DavidMFlynn/MapperRover/TrackUnit/PrintedParts/STL Files/SidePlateOutside.dxf

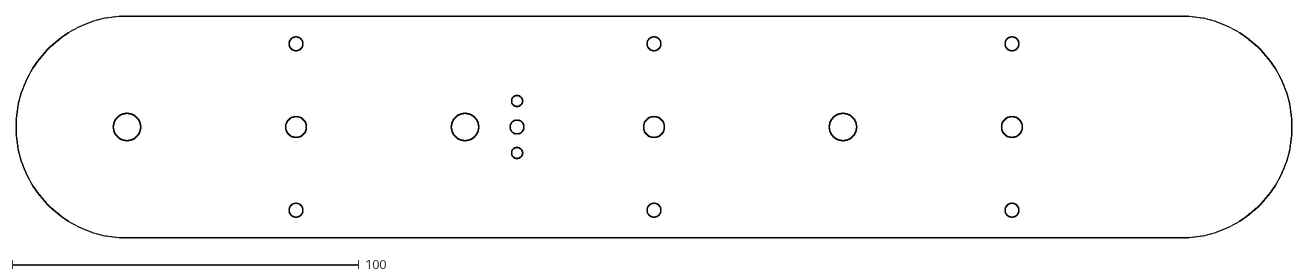
[picture p1: CAD file, 2017-04-08]
TrackUnit/PrintedParts/STL Files/SidePlateOutside.dxf
368.0 x 64.0
