DavidMFlynn/MapperRover/TrackUnit/PrintedParts/STL Files/RollPlate.stl

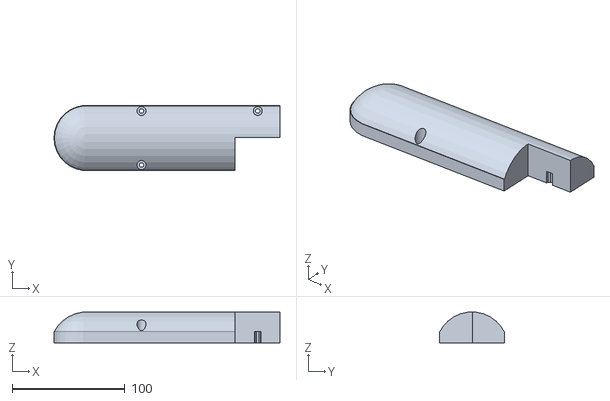
[picture p2: CAD file, 2017-04-08]
TrackUnit/PrintedParts/STL Files/RollPlate.stl
200.8 x 57.7 x 27.3
