DavidMFlynn/MapperRover/TrackUnit/PrintedParts/STL Files/IdleWheel.stl

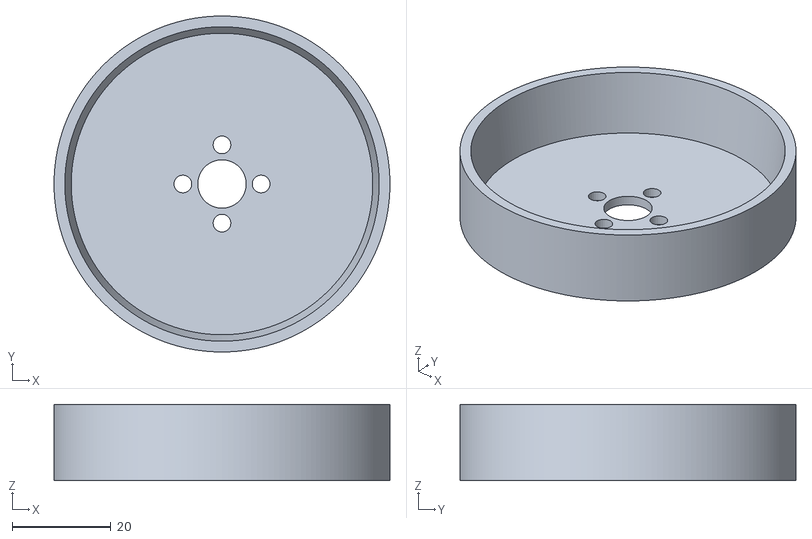
[picture p3: CAD file, 2017-04-08]
TrackUnit/PrintedParts/STL Files/IdleWheel.stl
68.0 x 68.0 x 15.4
