DavidMFlynn/MapperRover/TrackUnit/PrintedParts/STL Files/SidePlateInside.dxf

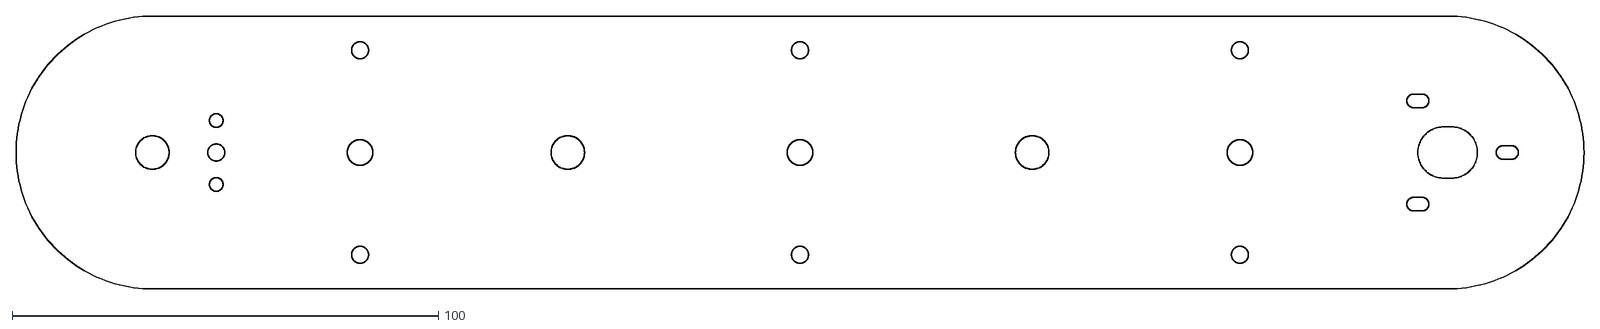
[picture p4: CAD file, 2017-04-08]
TrackUnit/PrintedParts/STL Files/SidePlateInside.dxf
368.0 x 64.0
