DavidMFlynn/MapperRover/TrackUnit/PrintedParts/STL Files/SidePlate.stl

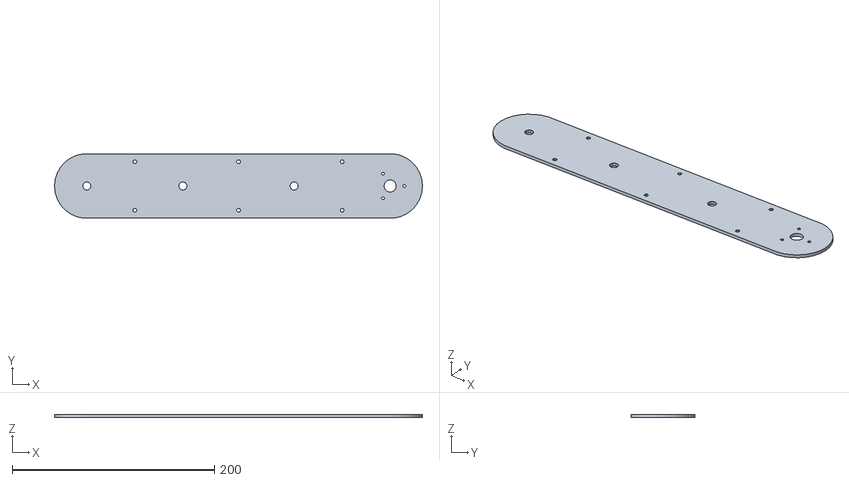
[picture p5: CAD file, 2017-04-08]
TrackUnit/PrintedParts/STL Files/SidePlate.stl
364.0 x 63.6 x 3.00
