DavidMFlynn/MapperRover/TrackUnit/PrintedParts/STL Files/TnB_Plate.dxf

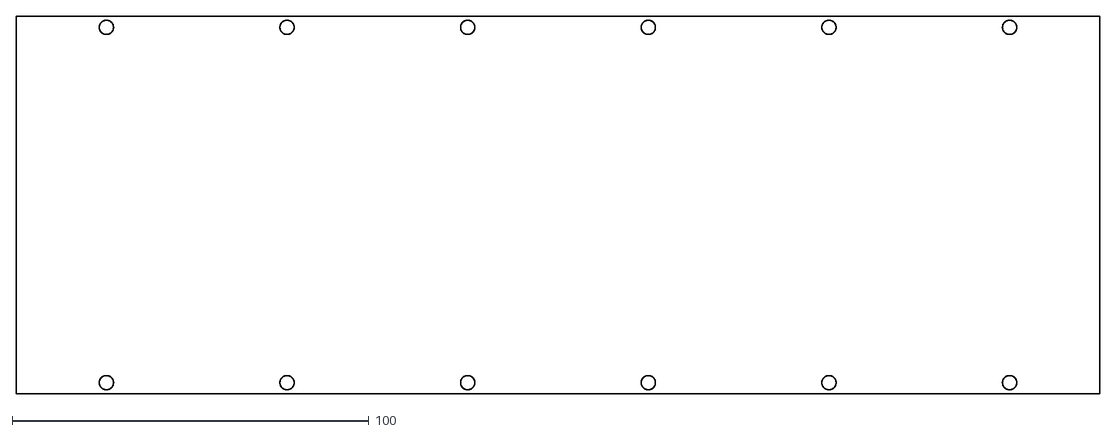
[picture p6: CAD file, 2017-04-08]
TrackUnit/PrintedParts/STL Files/TnB_Plate.dxf
304.0 x 106.0
