DavidMFlynn/MapperRover/TrackUnit/PrintedParts/STL Files/Emitter.stl

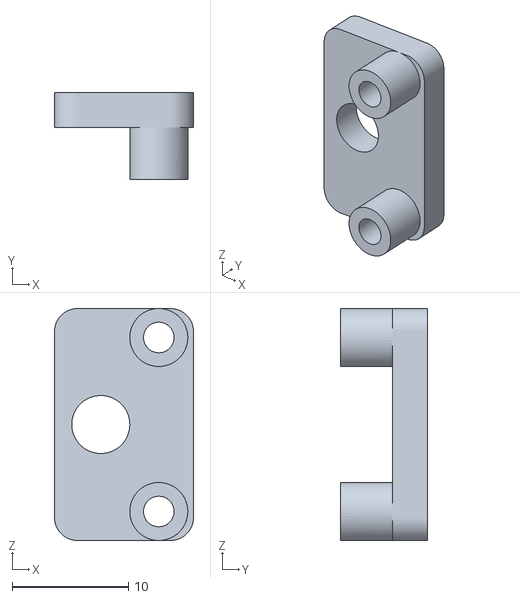
[picture p7: CAD file, 2017-04-08]
TrackUnit/PrintedParts/STL Files/Emitter.stl
12.0 x 7.50 x 20.0
