DavidMFlynn/MapperRover/TrackUnit/PrintedParts/STL Files/Sensor.stl

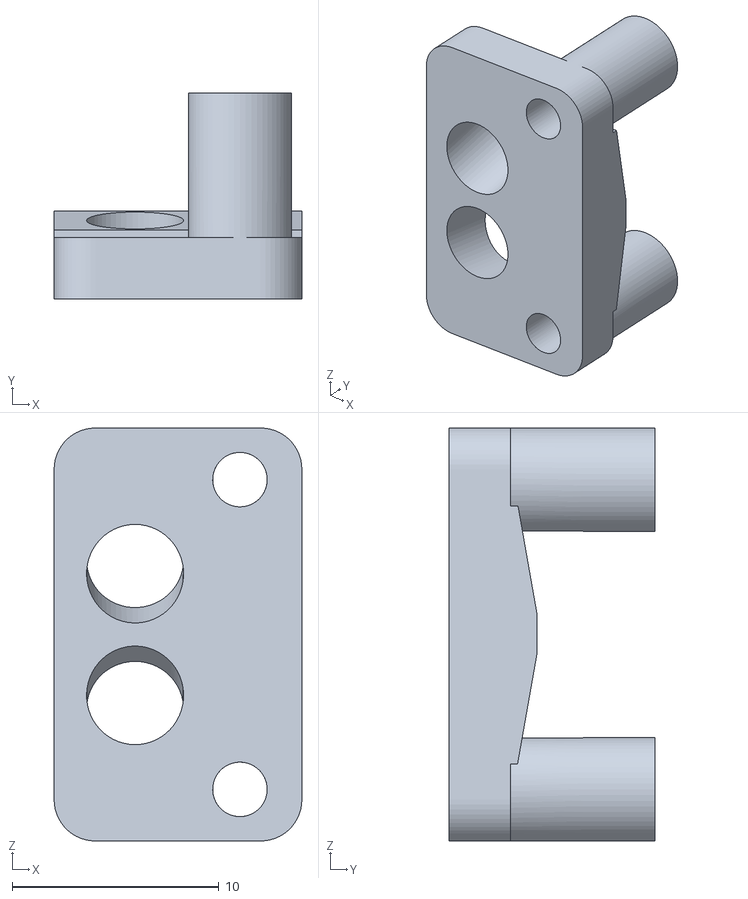
[picture p8: CAD file, 2017-04-08]
TrackUnit/PrintedParts/STL Files/Sensor.stl
12.0 x 10.0 x 20.0
