DavidMFlynn/MapperRover/(list of files, cad)

Other CAD files:
TrackUnit/PrintedParts/CommonStuff.scad
TrackUnit/PrintedParts/Tracks-N-Things.scad
TrackUnit/PrintedParts/STL Files/SidePlate.dxf
