DavidMFlynn/MapperRover/TrackUnit/DrivePCB/MotorDriveTop.pdf

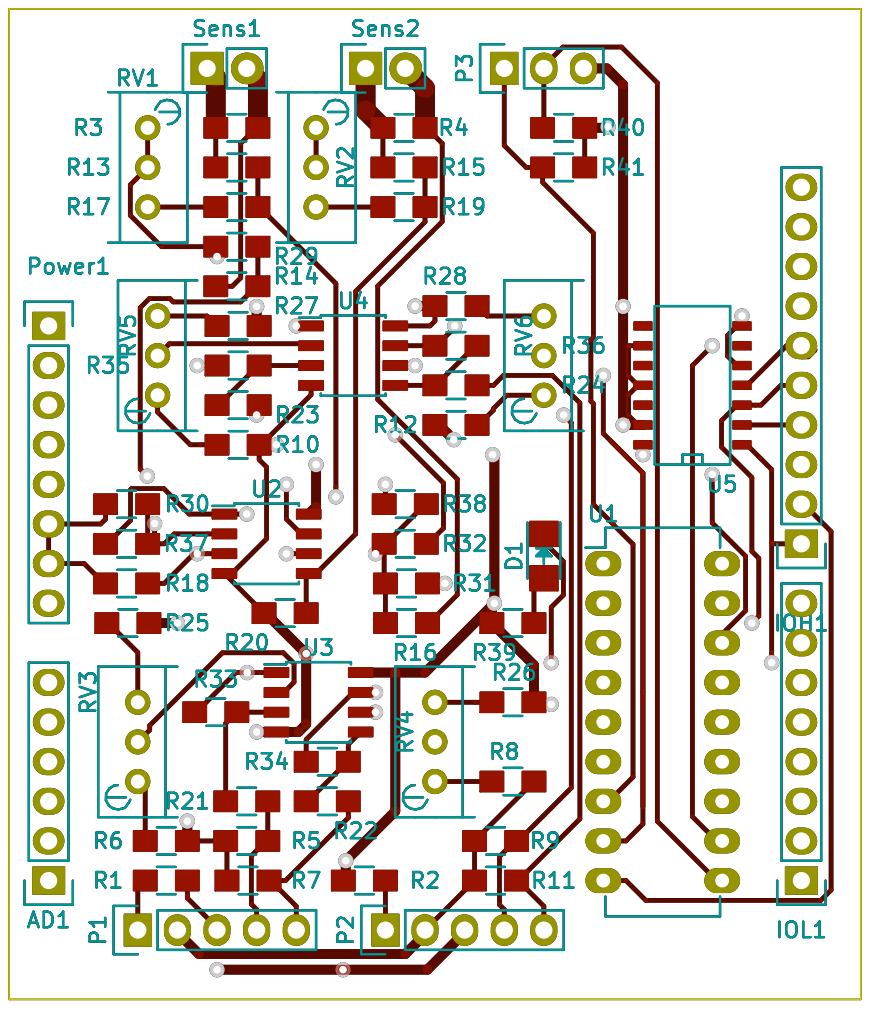
[picture p9: page 1]
