DavidMFlynn/MapperRover/TrackUnit/DrivePCB/MotorDriveRevA.sch.pdf

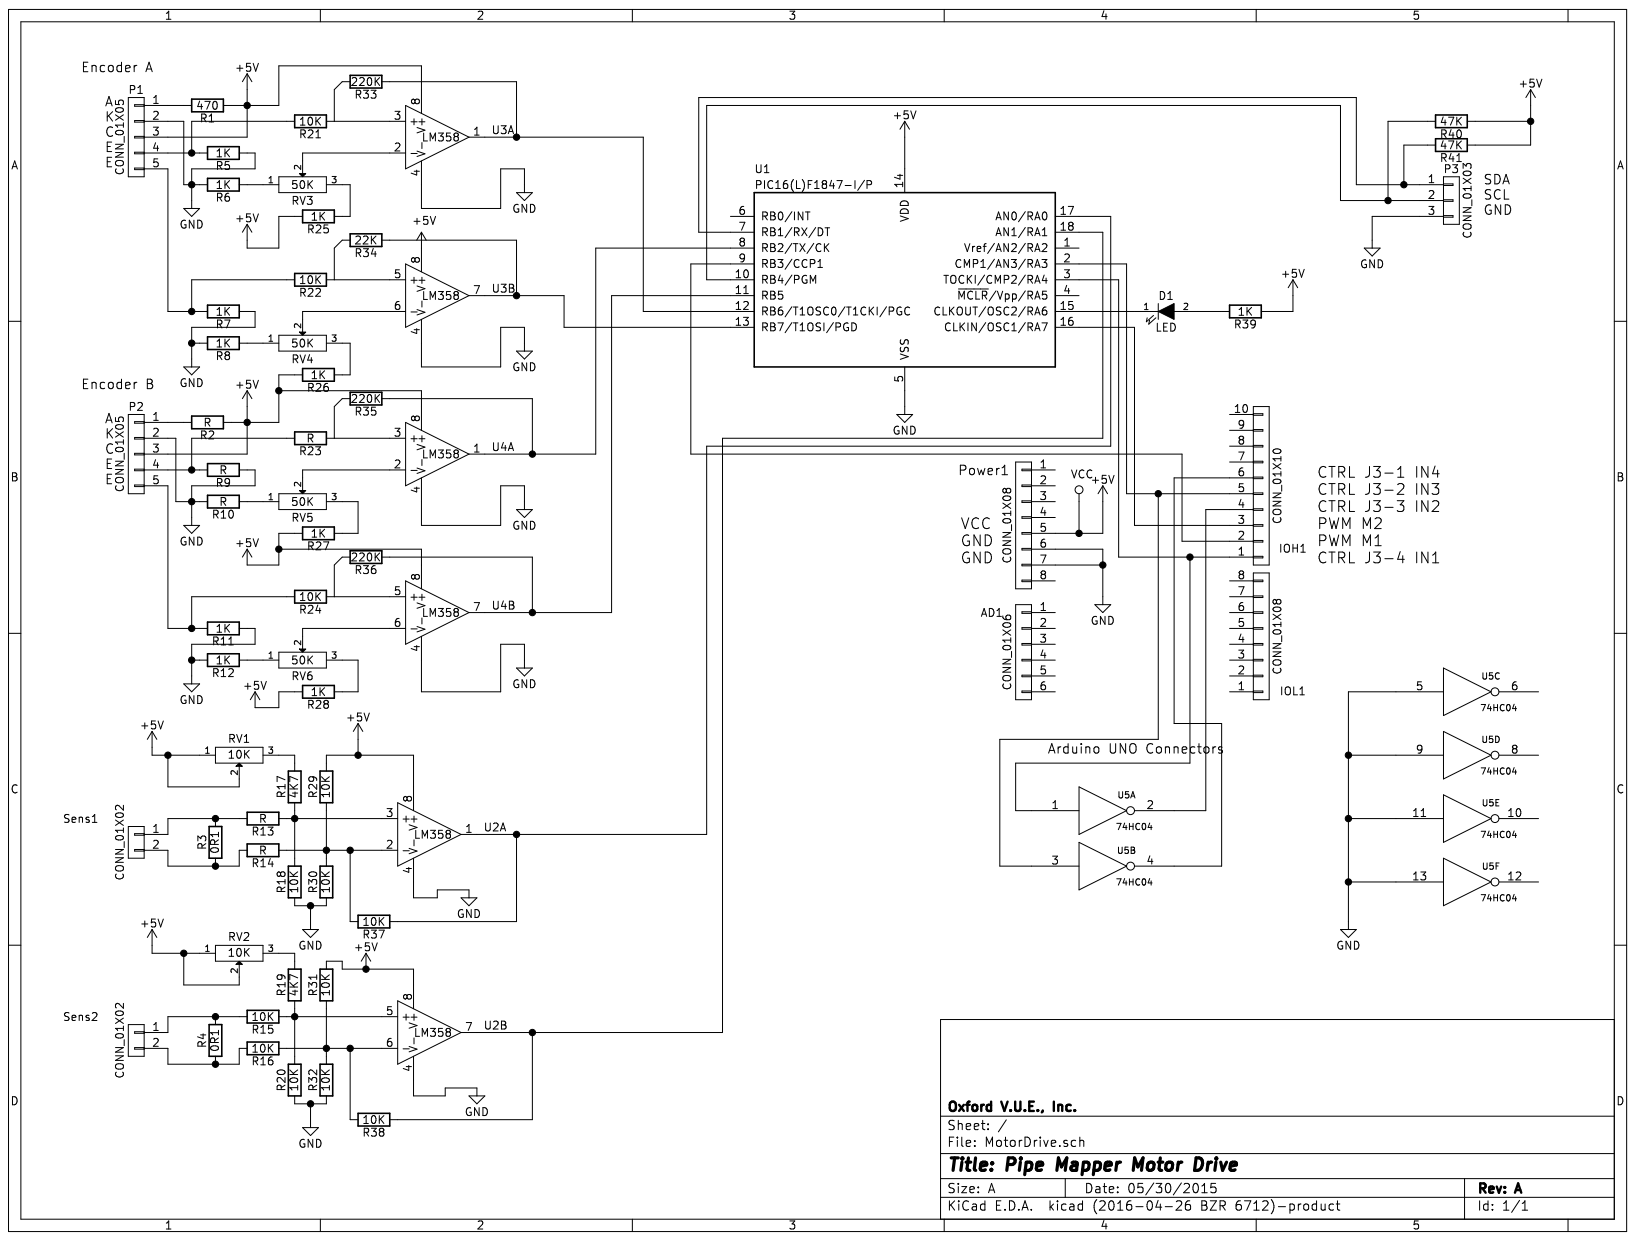
[picture p10: page 1]
