DavidMFlynn/MapperRover/TrackUnit/DrivePCB/MotorDrive.kicad_pcb

## KiCad design TrackUnit/DrivePCB/MotorDrive.kicad_pcb (2017-04-08)

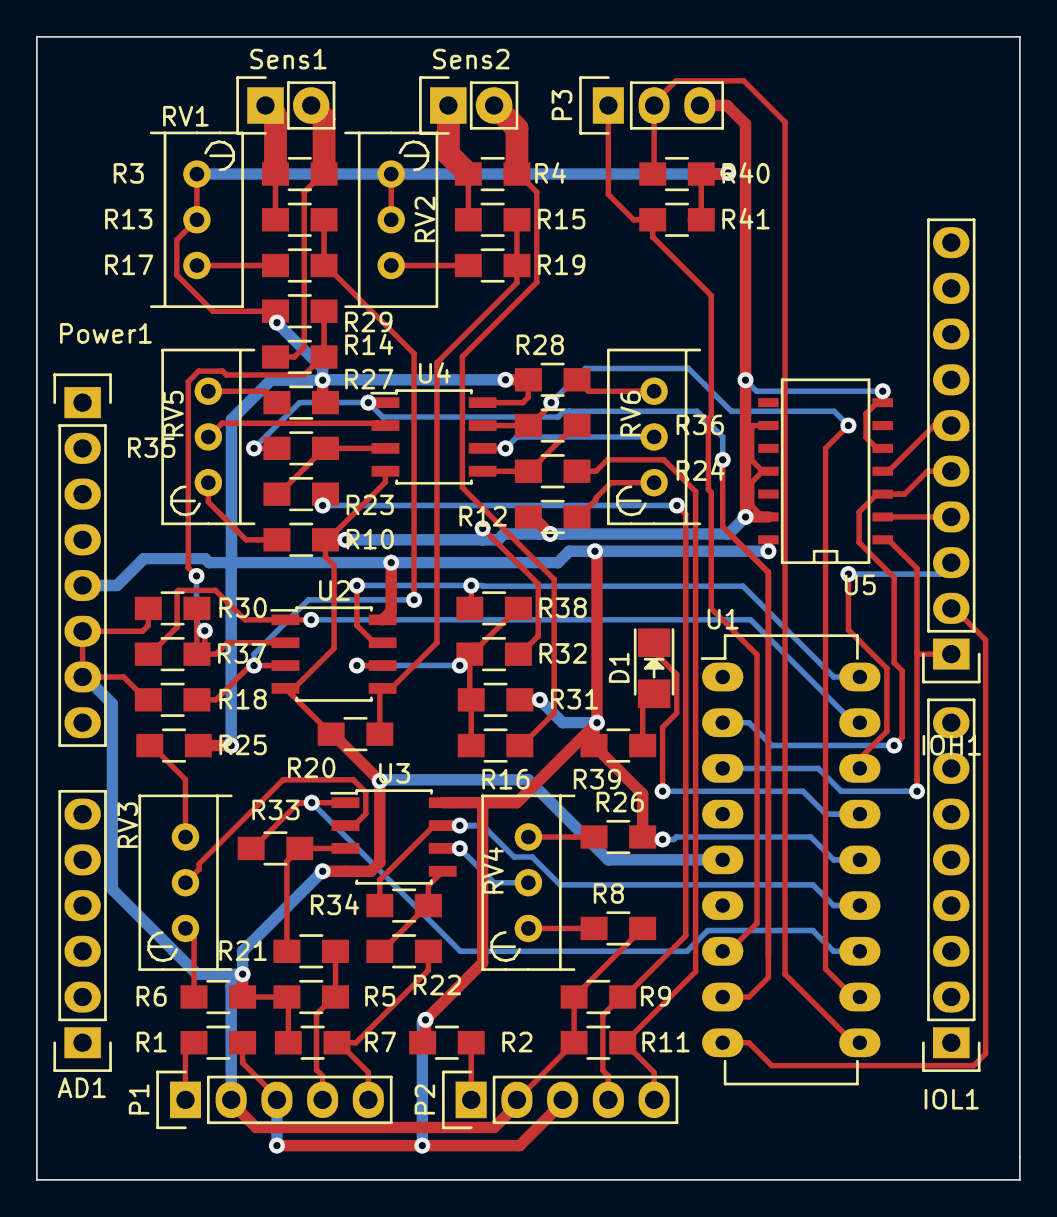
[picture p11: board MotorDrive.kicad_pcb from above]

Board: 2 copper layers, 54.6 x 63.5 mm, 62 parts (0 on the bottom side), 50 nets.

Parts:
AD1: CONN_01X06; Pin_Header_Straight_1x06
D1: LED; LED-1206
IOH1: CONN_01X10; Pin_Header_Straight_1x10
IOL1: CONN_01X08; Pin_Header_Straight_1x08
P1, P2: CONN_01X05; Pin_Header_Straight_1x05
P3: CONN_01X03; Pin_Header_Straight_1x03
Power1: CONN_01X08; Pin_Header_Straight_1x08
R1, R2, R3, R4, R5, R6, R7, R8, R9, R10, R11, R12, R13, R14, R15, R16, R17, R18, R19, R20, R21, R22, R23, R24, R25, R26, R27, R28, R29, R30, R31, R32, R33, R34, R35, R36, R37, R38, R39, R40, R41: R; R_0805_HandSoldering
RV1, RV2, RV3, RV4, RV5, RV6: POT; Potentiometer_Bourns_3296W_3-8Zoll_Inline_ScrewUp
Sens1, Sens2: CONN_01X02; Pin_Header_Straight_1x02
U1: PIC16(L)F1847-I/P; DIP-18_W7.62mm_LongPads
U2, U3, U4: LM358; SOIC-8_3.9x4.9mm_Pitch1.27mm
U5: 74HC04; SOIC-14_N

Connections:
+5V: P1.3, P2.3, Power1.5, R1.1, R2.1, R25.2, R26.2, R27.2, R28.2, R29.2, R31.2, R39.1, R40.1, R41.1, RV1.1, RV1.2, RV2.1, RV2.2, U1.14, U2.8, U3.8, U4.8, U5.14
GND: P1.2, P2.2, P3.3, Power1.6, Power1.7, R5.1, R6.2, R7.1, R8.2, R9.1, R10.2, R11.1, R12.2, R18.1, R20.1, R30.1, R32.1, U1.5, U2.4, U3.4, U4.4, U5.5, U5.7, U5.9, U5.11, U5.13
unnamed: D1.1, U1.15
unnamed: D1.2, R39.2
unnamed: IOH1.1, U1.3, U5.1
unnamed: IOH1.2, U1.9
unnamed: IOH1.3, U1.16
unnamed: IOH1.4, U5.2
unnamed: IOH1.5, U1.2, U5.3
unnamed: IOH1.6, U5.4
unnamed: P1.1, R1.2
unnamed: P1.4, R5.2, R21.2
unnamed: P1.5, R7.2, R22.2
unnamed: P2.1, R2.2
unnamed: P2.4, R9.2, R23.2
unnamed: P2.5, R11.2, R24.2
unnamed: P3.1, R41.2, U1.7
unnamed: P3.2, R40.2, U1.10
unnamed: R6.1, RV3.1
unnamed: R8.1, RV4.1
unnamed: R10.1, RV5.1
unnamed: R12.1, RV6.1
unnamed: R13.1, R17.1, R18.2, U2.3
unnamed: R3.2, R13.2, Sens1.1
unnamed: R14.1, R29.1, R30.2, R37.2, U2.2
unnamed: R3.1, R14.2, Sens1.2
unnamed: R15.1, R19.1, R20.2, U2.5
unnamed: R4.2, R15.2, Sens2.1
unnamed: R16.1, R31.1, R32.2, R38.2, U2.6
unnamed: R4.1, R16.2, Sens2.2
unnamed: R17.2, RV1.3
unnamed: R19.2, RV2.3
unnamed: R21.1, R33.2, U3.3
unnamed: R22.1, R34.2, U3.5
unnamed: R23.1, R35.2, U4.3
unnamed: R24.1, R36.2, U4.5
unnamed: R25.1, RV3.3
unnamed: R26.1, RV4.3
unnamed: R27.1, RV5.3
unnamed: R28.1, RV6.3
unnamed: R33.1, U1.12, U3.1
unnamed: R34.1, U1.13, U3.7
unnamed: R35.1, U1.8, U4.1
unnamed: R36.1, U1.11, U4.7
unnamed: R37.1, U1.17, U2.1
unnamed: R38.1, U1.18, U2.7
unnamed: RV3.2, U3.2
unnamed: RV4.2, U3.6
unnamed: RV5.2, U4.2
unnamed: RV6.2, U4.6
