DavidMFlynn/MapperRover/(commit log)

2017-04-08 new repo
    [CommonStuff.scad, Emitter.stl, IdleWheel.stl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]
2017-04-09 minor fix
    [MotorDrive.sch]
2017-04-12 PWM init
2017-04-13 Motor test is go
2017-04-14 Added I2C stuff
2017-04-18 PID started
2017-10-04 pcb top pdf
