DavidMFlynn/MapperRover/(notices)

Notices in the files:
TrackUnit/DrivePCB/MotorDrive.kicad_pcb:
DMFE 2016 GPL v2.0
